mteiste/hauki/(commit log)

2026-05-31 Restructure repo for two-platform layout
    Moves all Pico W (MicroPython) code into pico/ subdirectory and updates
    the root README to serve as a project overview pointing to both platform
    directories. No code changes — purely a filesystem reorganisation.
    The rpi/ directory for the Raspberry Pi 1A+ implementation follows in
    subsequent commits.
2026-05-31 Add RPi implementation design spec
    Documents the architecture, module changes, configuration schema, and
    systemd service design for the Raspberry Pi 1A+ port of HAUKI.
2026-05-31 Add RPi implementation plan
    Step-by-step implementation plan for the Raspberry Pi 1A+ port covering
    all 11 tasks from project scaffold through systemd service deployment.
2026-05-31 rpi: add nordpool (copied from pico, unchanged)
2026-05-31 rpi: add eink display driver (luma.epd + Pillow)
2026-10-30 rpi: read prices from the ENTSO-E sensor, rename nordpool to prices
    Home Assistant moved from the Nord Pool integration to entsoe_prices
    (sensor.electricity_price). Its payload has no flat today/tomorrow
    lists; the price curve is only in raw_today/raw_tomorrow as 15-minute
    items with UTC timestamps and price_ct_kwh.
    The parser now concatenates raw_today and raw_tomorrow, ignoring
    tomorrow_valid. ENTSO-E publishes the first slots of the next local day
    with today's auction, and every slot present is a final price. It stops
    at the first gap so the slot index arithmetic stays valid. Slot math and
    the cheapest-window search are unchanged.
    nordpool.py/NordPool becomes prices.py/Prices, and the c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
2026-10-30 rpi: add Raspberry Pi setup guide
    Documents the manual OS preparation of the Pi 1A+ (Raspbian trixie):
    optional passwordless sudo, apt packages, SPI on, KMS/camera off with
    gpu_mem=16, blocking the VideoCore camera/codec modules, reducing SD
    card writes (apt timers off, zram writeback manual) and the hauki
    service user. Notes that RPi.GPIO fails on this board's old-style
    revision code.
2026-10-30 rpi: replace luma.epd with a spidev + lgpio e-paper driver
    luma.epd, which eink.py was written against, does not exist. The new
    src/epd.py drives the Waveshare 2.13" V4 HAT (SSD1680) directly:
    spidev on SPI0 CE0 (the kernel drives chip select) and lgpio on
    gpiochip0 for RST/DC/BUSY. RPi.GPIO cannot be used on the Pi 1A+: it
    rejects the board's old-style revision code. lgpio is imported lazily
    because it creates a notification pipe in $LG_WD on import.
    The RAM layout follows Waveshare's RPi driver for the HAT (data entry
    mode 0x03, landscape image rotated 90 degrees). Fast refresh now really
    is fast: after each full refresh the fast OTP waveform is loaded with a
    fake 100 C temperature. Measu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
    [eink.py, epd.py]
2026-10-30 rpi: fit the price layout to the panel for prices up to 999.99 c/kWh
    The coordinates came from the Pico, whose compiled fonts have different
    metrics from DejaVu in Pillow. The unit overlapped the 2h/4h line, and
    wide prices ran off the 250 px panel.
    Lines are now positioned by baseline. The unit sits right-aligned on
    the big price's line, and the 1h line drops from 32 to 30 px. At the
    worst case (every price 999.99) the lines are 168 + 43, 241 and 246 px
    wide, all within the panel and not overlapping; also checked with
    -99.99. The test tool's wide sample now uses 999.99 everywhere.
2026-10-30 rpi: use the OS time zone directly, drop timezone.py
    The OS owns the clock (network time) and the local time zone
    (/etc/localtime, including DST), and ENTSO-E timestamps are UTC, so the
    LocalTimezone wrapper and the "timezone" config section are
    unnecessary. prices.py and scheduler.py now call time.time(),
    datetime.fromisoformat().timestamp() and time.strftime() with
    time.localtime() directly. The unused is_tomorrow() goes with it.
    Verified on the Pi with live HA data: same prices and cheapest windows
    as before, all slot times identical to the old ZoneInfo conversion, and
    correct local times across the March and October 2026 DST changes.
    The README gets a "Time zone and clock" step coverin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
    [config.py, main.py, prices.py, scheduler.py]
2026-10-30 rpi: align the scheduler to the minute, redraw right after an error
    Two scheduler problems:
    - After an error screen, a recovery within the same quarter did not
    redraw the price, because the slot was still marked as shown. The
    error stayed up for up to 15 minutes. run() is entered at startup and
    after every error screen, so it now forgets the shown slot first.
    - The loop slept 60 s from the last pass, so a new price appeared up to
    a minute after its quarter started, and slow passes drifted.
    The loop and main.py's error retry now both use
    sleep_until_next_minute(), which wakes 1 s past each full minute.
    Quarter boundaries are full minutes, so new prices show within seconds.
    Checked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
    [main.py, scheduler.py]
2026-10-30 Make HAUKI a Raspberry Pi-only project at the repository top level
    The Pico W (MicroPython) implementation is finished and no longer
    developed. It is preserved on branch "pico" and tag "pico-1.0" (the old
    master).
    - Remove pico/, the Pico documentation (docs/copilot.md,
    display_rendering.md, eink_display.md, fonts.md), the completed Pico
    to RPi port plan, and the Copilot instructions (Copilot is no longer
    used for this project).
    - Move everything from rpi/ to the top level: src/, tools/, LICENSES/,
    Makefile, hauki.service, config.json.example, requirements.txt and
    .ruff.toml. The RPi setup guide becomes README.md, with a new intro and
    a license section; the old overview and agen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
    [config.py, eink.py, epd.py, exceptions.py, healthcheck.py, homeassistant.py, main.py]
2026-10-30 Restore dev tooling: make prepare installs Ruff and markdownlint
    The move to the top level left no reproducible way to install the
    linters: Ruff was in no requirements file, and markdownlint's
    package.json was removed with the Pico code.
    - requirements-dev.txt: runtime requirements plus Ruff, and Pillow
    pinned to the Pi's 11.1.0 so PNG previews match the panel.
    - package.json: markdownlint-cli2 with a lint:markdown script.
    - make prepare: creates .venv with uv (falling back to python3 -m
    venv), installs the dev requirements, keeps a pinned local Node.js
    22.23.4 in .nodejs/ (the system node may lack npm), and installs
    markdownlint. It is for the workstation only.
    - make lint runs lin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
2026-10-30 Display redesign, metering interval support, and Pi deployment
    Display (src/eink.py):
    - Every screen has a header: date left, unit centred (price screen only),
    current slot time right, and a rule underneath, so a frozen e-paper
    image is easy to tell apart from a running system.
    - The current price is 42 px and centred. The cheapest windows are three
    boxes: "1h"/"2h"/"4h" and the start time on one line, and the average
    price below, so prices are always the largest numbers. Everything fits
    at 999.99 c/kWh.
    - "ERROR" is smaller and centred below the header.
    Metering interval (src/prices.py, src/scheduler.py):
    - New prices.metering_interval: 900 for quarter-hour metering (default,
    w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
    [eink.py, prices.py, scheduler.py]
2026-10-30 Keep showing prices through short network outages
    The Pi's Wi-Fi is weak (-77 dBm) and drops for a few seconds now and
    then. The health check pinged HA every minute and showed "Could not
    reach HA" on the first failure, although the prices already held were
    still valid.
    The health check now only fails when there is no price for the current
    slot. Day-ahead prices are final once published and are held up to a
    day ahead. A failed refresh keeps the old data and is retried every
    minute. When prices do run out, the error is "Could not reach HA" if HA
    is unreachable, otherwise "Could not fetch prices" with the reason.
    This also removes the once-a-minute HA request.
    Checked with a simulated clock a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
    [healthcheck.py]
2026-10-30 README: name the source of each SD-write measure and how to add it
    The SD-write section claimed "stock trixie" does the usual things. On
    the Pi, only /tmp as tmpfs is a Debian 13 default (systemd tmp.mount).
    The volatile journal comes from Raspberry Pi OS's raspberrypi-sys-mods
    drop-in, and noatime is in the Raspberry Pi OS image's /etc/fstab.
    The table now lists the source of each measure, with instructions when
    one is missing: install raspberrypi-sys-mods, or add noatime to the
    root line in /etc/fstab and remount.
2026-10-30 Add the case model and its make targets
    OpenSCAD sources in case/. The exported case.3mf stays out of the repo
    and renders go to the already ignored case/build/.
    [case.scad, hardware.scad]
2026-10-30 deploy: leave case/ and docs/ off the Pi
2026-10-30 Add press-in plugs for the Pi's lower mounting holes
    They replace the self-tapping M2.5 screws. The tray is unchanged, and
    the plate carries a pair of each tip size because printed fit varies.
    [case.scad]
2026-11-01 Make the display's bottom boxes configurable
    display.boxes picks what each of the three boxes shows: the new next hour,
    today and tomorrow average prices, or the existing cheapest 1h/2h/4h windows.
    The averages are the new default.
    A box without data shows -- instead of crashing the update. Tomorrow needs
    the sensor's tomorrow_valid, since raw_tomorrow holds early slots before the
    day is complete. A wrong boxes value goes to the error screen.
    [eink.py, exceptions.py, prices.py, scheduler.py]
2026-11-06 Refresh prices often until tomorrow's are valid
    The price data was fetched only every refresh_interval (4 h), so a fetch
    made shortly before Home Assistant got tomorrow's prices kept the
    tomorrow box at "--" for up to four hours. While tomorrow_valid is false,
    refresh at tomorrow_refresh_interval (default 900 s) instead.
    [prices.py]
